DavidZambrano28/Electrical-Systems-Phoenix-Autonomy/PCB-MainBoard/PDB.kicad_pcb

## KiCad design PCB-MainBoard/PDB.kicad_pcb (2026-11-06)

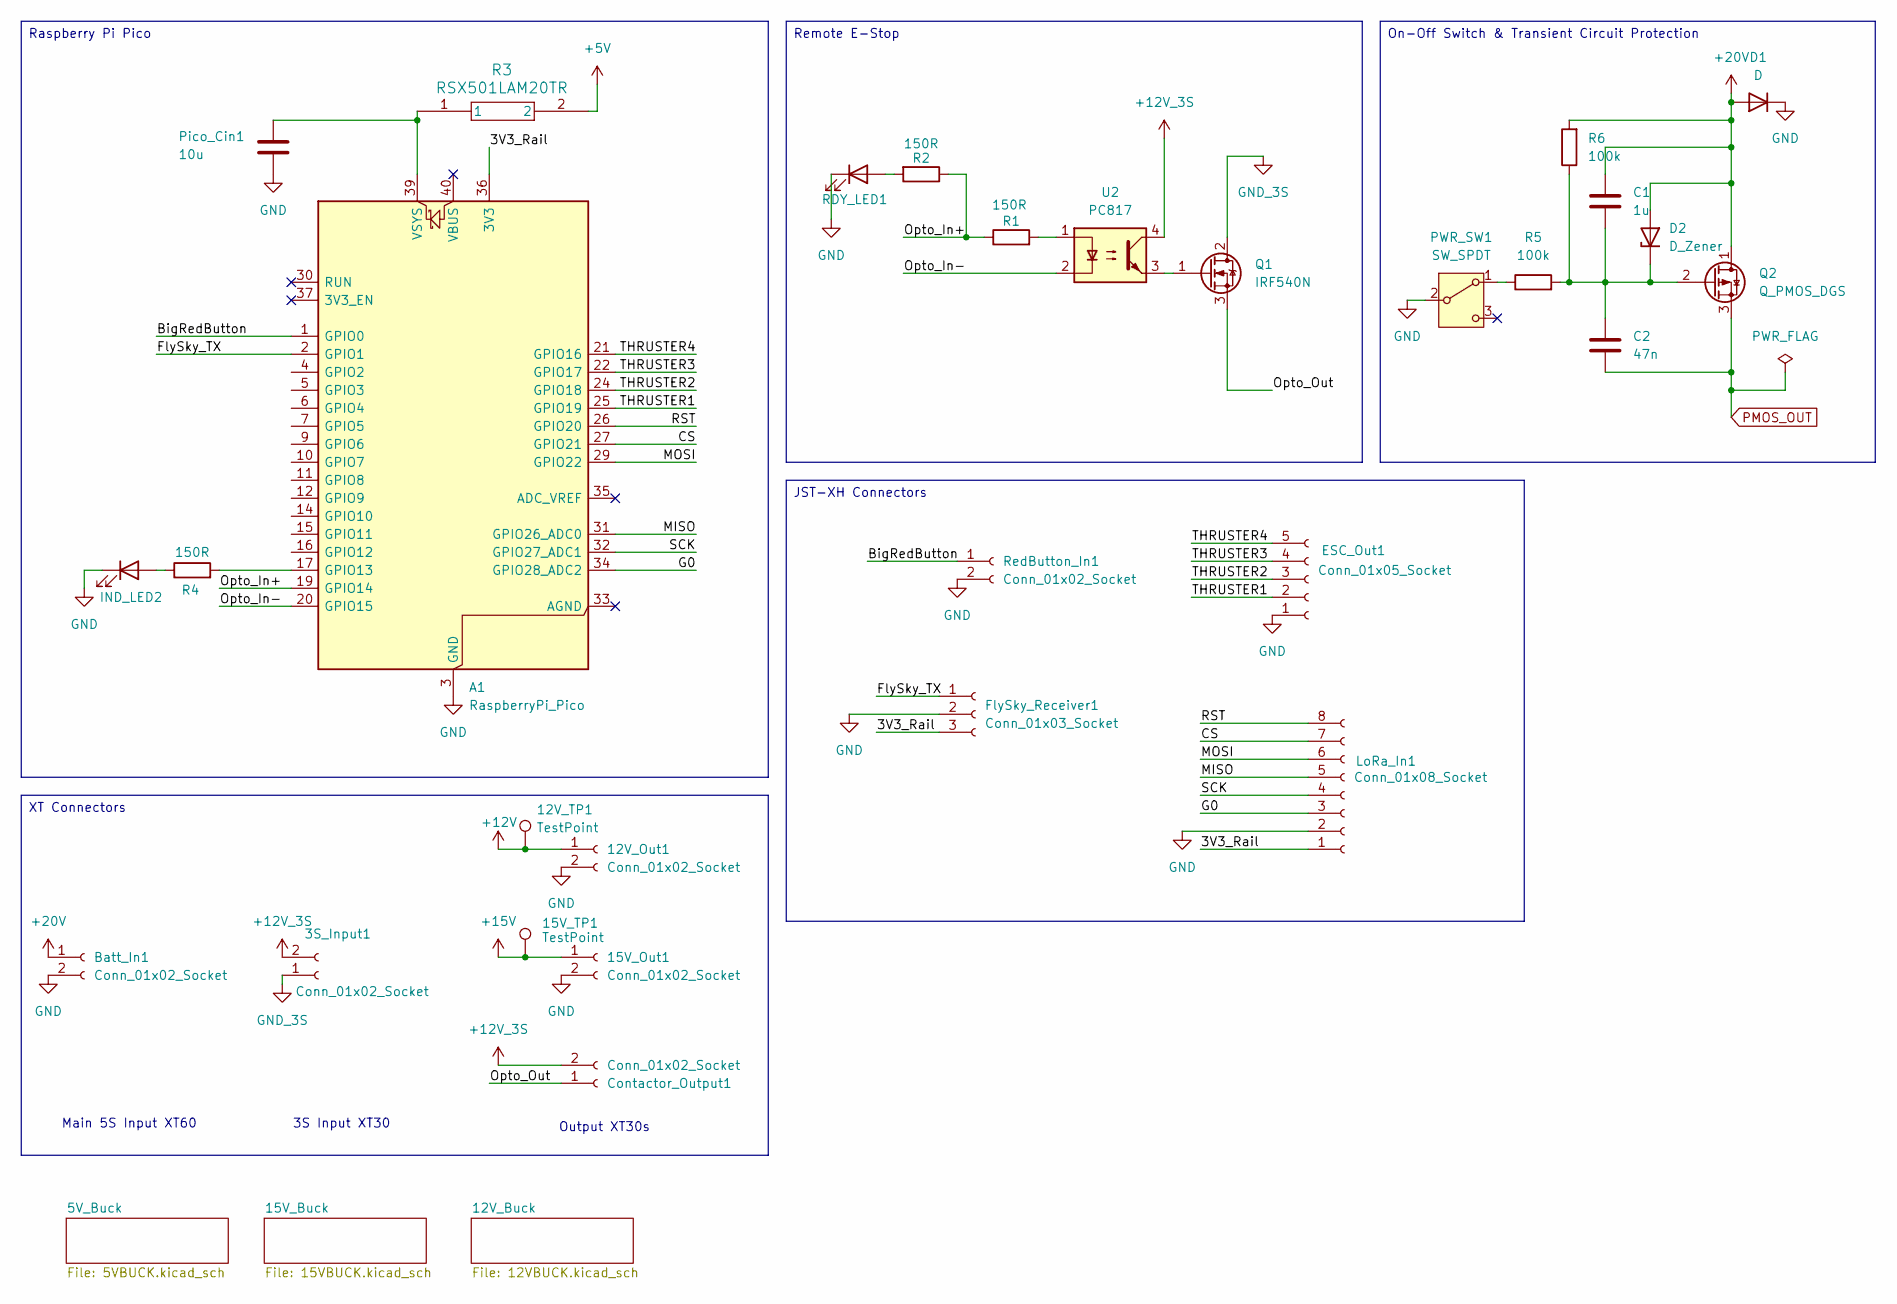
[picture p1: schematic PDB.kicad_sch]

Parts:
3S_Input1: Conn_01x02_Socket; AMASS_XT30U-M_1x02_P5.0mm_Vertical
12V_Out1, 15V_Out1: Conn_01x02_Socket; AMASS_XT30U-F_1x02_P5.0mm_Vertical
12V_TP1, 15V_TP1: TestPoint; TestPoint_Pad_D2.0mm
A1: RaspberryPi_Pico; RaspberryPi_Pico_Common_THT
Batt_In1: Conn_01x02_Socket; AMASS_XT60-M_1x02_P7.20mm_Vertical
C1: 1u; C_0603_1608Metric
C2: 47n; C_0603_1608Metric
Contactor_Output1: Conn_01x02_Socket; AMASS_XT30U-F_1x02_P5.0mm_Vertical
D1: D; D_SMC
D2: D_Zener; D_SMB
ESC_Out1: Conn_01x05_Socket; JST_XH_B5B-XH-A_1x05_P2.50mm_Vertical
FlySky_Receiver1: Conn_01x03_Socket; JST_XH_B3B-XH-A_1x03_P2.50mm_Vertical
IND_LED2: LED; LED_D5.0mm
LoRa_In1: Conn_01x08_Socket; JST_XH_B8B-XH-A_1x08_P2.50mm_Vertical
PWR_SW1: SW_SPDT; SW_Slide_SPDT_Straight_CK_OS102011MS2Q
Pico_Cin1: 10u; C_0805_2012Metric
Q1: IRF540N; TO-220-3_Vertical
Q2: Q_PMOS_DGS; TO-252-3_TabPin2
R1, R2, R4: 150R; R_0805_2012Metric
R3: RSX501LAM20TR; DIO_RB050LAM_ROM
R5, R6: 100k; R_0603_1608Metric
RDY_LED1: LED; LED_D5.0mm
RedButton_In1: Conn_01x02_Socket; JST_XH_B2B-XH-A_1x02_P2.50mm_Vertical
U2: PC817; DIP-4_W7.62mm

Connections:
+5V: R3.2; also elsewhere on the board
+12V: 12V_Out1.1, 12V_TP1.1 (1_1); also elsewhere on the board
+12V_3S: 3S_Input1.2, Contactor_Output1.2, U2.4
+15V: 15V_Out1.1, 15V_TP1.1 (1_1); also elsewhere on the board
+20V: Batt_In1.1, C1.1, D1.2 (A), D2.2 (A), Q2.1 (D), R6.2
/3V3_Rail: A1.36 (3V3), FlySky_Receiver1.3, LoRa_In1.1
/BigRedButton: A1.1 (GPIO0), RedButton_In1.1
/CS: A1.27 (GPIO21), LoRa_In1.7
/FlySky_TX: A1.2 (GPIO1), FlySky_Receiver1.1
/G0: A1.34 (GPIO28_ADC2), LoRa_In1.3
/MISO: A1.31 (GPIO26_ADC0), LoRa_In1.5
/MOSI: A1.29 (GPIO22), LoRa_In1.6
/Opto_In+: A1.19 (GPIO14), R1.1, R2.1
/Opto_In-: A1.20 (GPIO15), U2.2
/Opto_Out: Contactor_Output1.1, Q1.3 (S)
/RST: A1.26 (GPIO20), LoRa_In1.8
/SCK: A1.32 (GPIO27_ADC1), LoRa_In1.4
/THRUSTER1: A1.25 (GPIO19), ESC_Out1.2
/THRUSTER2: A1.24 (GPIO18), ESC_Out1.3
/THRUSTER3: A1.22 (GPIO17), ESC_Out1.4
/THRUSTER4: A1.21 (GPIO16), ESC_Out1.5
GND: 12V_Out1.2, 15V_Out1.2, A1.3 (GND), A1.8 (GND), A1.13 (GND), A1.18 (GND), A1.23 (GND), A1.28 (GND), A1.38 (GND), Batt_In1.2, D1.1 (K), ESC_Out1.1, FlySky_Receiver1.2, IND_LED2.1 (K), LoRa_In1.2, PWR_SW1.2 (B), Pico_Cin1.2, RDY_LED1.1 (K), RedButton_In1.2; also elsewhere on the board
GND_3S: 3S_Input1.1, Q1.2 (D)
unnamed: A1.17 (GPIO13), R4.2
unnamed: A1.39 (VSYS), Pico_Cin1.1, R3.1
unnamed: C1.2, C2.1, D2.1 (K), Q2.2 (G), R5.2, R6.1
unnamed: IND_LED2.2 (A), R4.1
unnamed: PWR_SW1.1 (A), R5.1
unnamed: Q1.1 (G), U2.3
unnamed: R1.2, U2.1
unnamed: R2.2, RDY_LED1.2 (A)
PMOS_OUT: C2.2, Q2.3 (S); also elsewhere on the board

Notes on the sheet:
Main 5S Input XT60
Output XT30s
3S Input XT30
On-Off Switch & Transient Circuit Protection
Raspberry Pi Pico
XT Connectors
Remote E-Stop
JST-XH Connectors

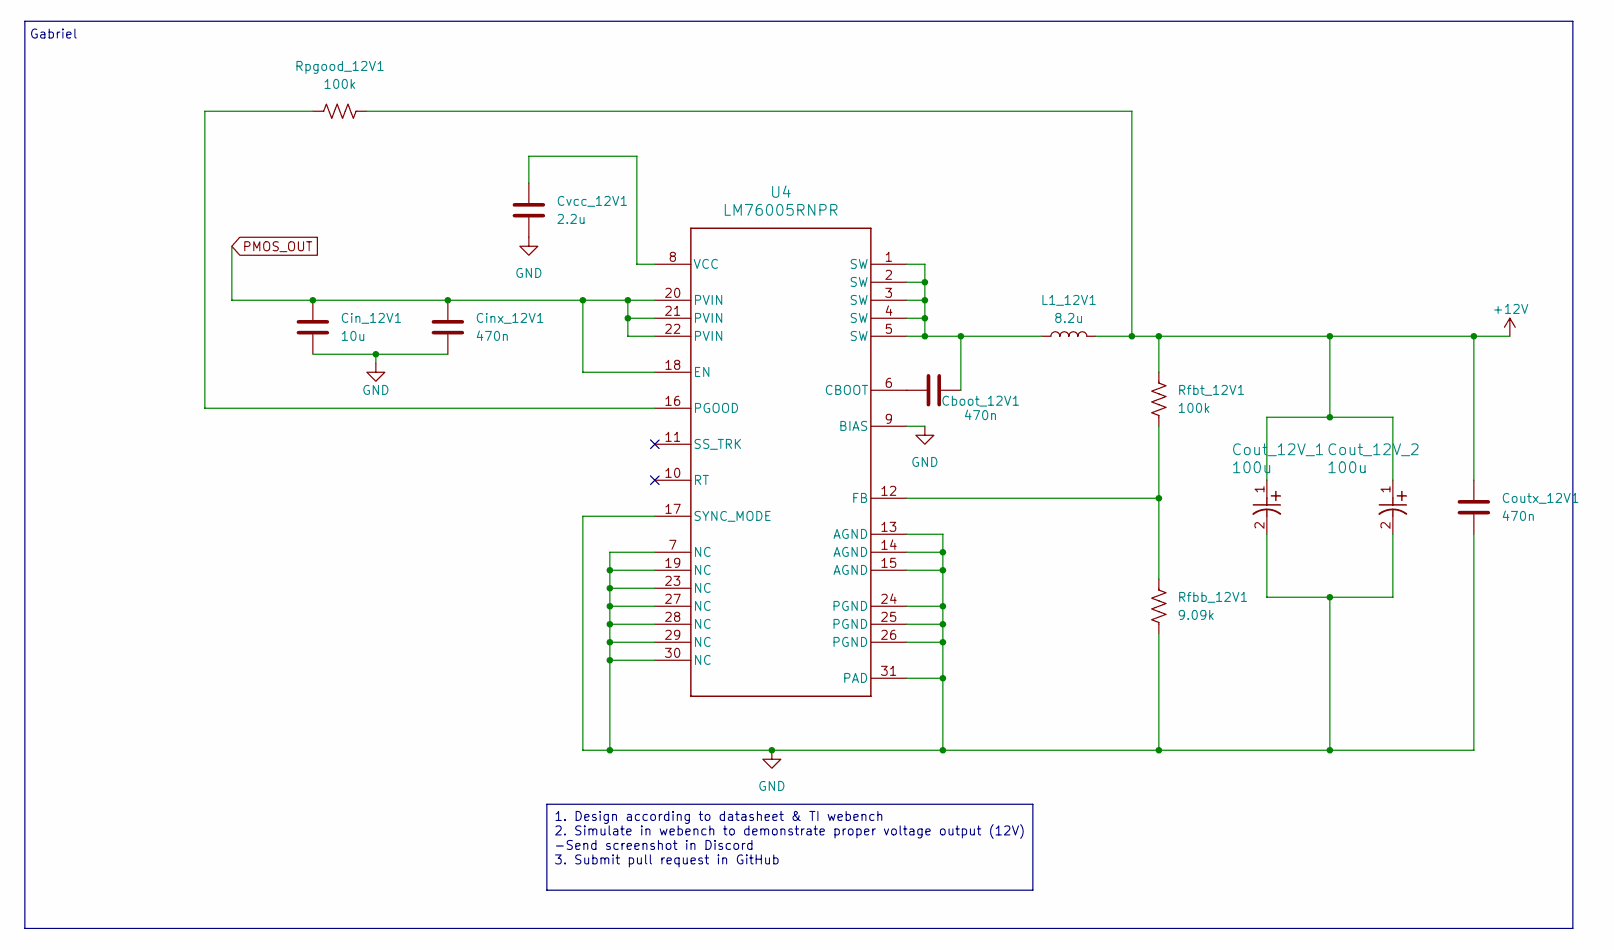
[picture p2: schematic 12VBUCK.kicad_sch, 12V Buck Converter]

Parts:
Cboot_12V1: 470n; C_0805_2012Metric
Cin_12V1: 10u; C_0805_2012Metric
Cinx_12V1: 470n; C_0805_2012Metric
Cout_12V_1, Cout_12V_2: 100u; CAP_EEFK_F_PAN
Coutx_12V1: 470n; C_0805_2012Metric
Cvcc_12V1: 2.2u; C_0603_1608Metric
L1_12V1: 8.2u; L_Bourns_SRP7028A_7.3x6.6mm
Rfbb_12V1: 9.09k; R_0603_1608Metric
Rfbt_12V1: 100k; R_0603_1608Metric
Rpgood_12V1: 100k; R_0603_1608Metric
U4: LM76005RNPR; RNP0030A

Connections:
+12V: Cout_12V_1.1, Cout_12V_2.1, Coutx_12V1.1, L1_12V1.2, Rfbt_12V1.2, Rpgood_12V1.2; also elsewhere on the board
GND: Cin_12V1.2, Cinx_12V1.2, Cout_12V_1.2, Cout_12V_2.2, Coutx_12V1.2, Cvcc_12V1.2, Rfbb_12V1.1, U4.7 (NC), U4.9 (BIAS), U4.13 (AGND), U4.14 (AGND), U4.15 (AGND), U4.17 (SYNC_MODE), U4.19 (NC), U4.23 (NC), U4.24 (PGND), U4.25 (PGND), U4.26 (PGND), U4.27 (NC), U4.28 (NC), U4.29 (NC), U4.30 (NC), U4.31 (PAD); also elsewhere on the board
unnamed: Cboot_12V1.1, L1_12V1.1, U4.1 (SW), U4.2 (SW), U4.3 (SW), U4.4 (SW), U4.5 (SW)
unnamed: Cboot_12V1.2, U4.6 (CBOOT)
unnamed: Rfbb_12V1.2, Rfbt_12V1.1, U4.12 (FB)
unnamed: Rpgood_12V1.1, U4.16 (PGOOD)
unnamed: Cvcc_12V1.1, U4.8 (VCC)
PMOS_OUT: Cin_12V1.1, Cinx_12V1.1, U4.18 (EN), U4.20 (PVIN), U4.21 (PVIN), U4.22 (PVIN); also elsewhere on the board

Notes on the sheet:
Gabriel
1. Design according to datasheet & TI webench 2. Simulate in webench to demonstrate proper voltage output (12V) -Send screenshot in Discord 3. Submit pull request in GitHub

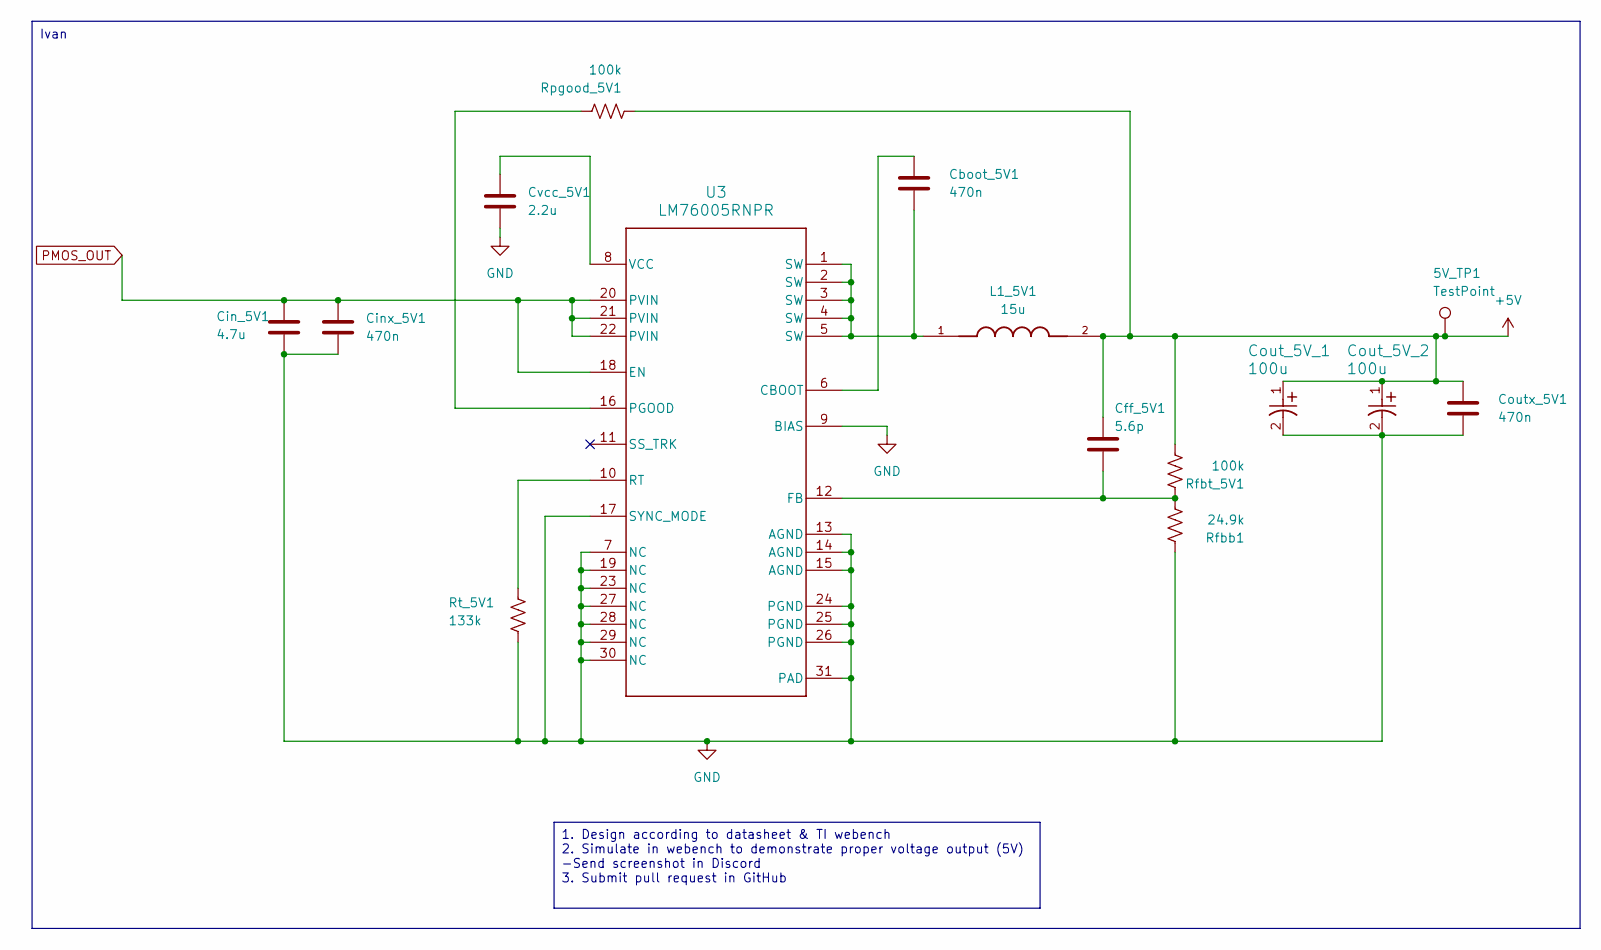
[picture p3: schematic 5VBUCK.kicad_sch, 5V Buck Converter]

Parts:
5V_TP1: TestPoint; TestPoint_Pad_D2.0mm
Cboot_5V1: 470n; C_0805_2012Metric
Cff_5V1: 5.6p; C_0603_1608Metric
Cin_5V1: 4.7u; C_0805_2012Metric
Cinx_5V1: 470n; C_0805_2012Metric
Cout_5V_1, Cout_5V_2: 100u; CAP_EEFK_F_PAN
Coutx_5V1: 470n; C_0805_2012Metric
Cvcc_5V1: 2.2u; C_0603_1608Metric
L1_5V1: 15u; IND_1217AS-H-150M=P3; PARTREV N/A
Rfbb1: 24.9k; R_0603_1608Metric
Rfbt_5V1: 100k; R_0603_1608Metric
Rpgood_5V1: 100k; R_0603_1608Metric
Rt_5V1: 133k; R_0603_1608Metric
U3: LM76005RNPR; RNP0030A

Connections:
+5V: 5V_TP1.1 (1_1), Cff_5V1.1, Cout_5V_1.1, Cout_5V_2.1, Coutx_5V1.1, L1_5V1.2, Rfbt_5V1.2, Rpgood_5V1.2; also elsewhere on the board
GND: Cin_5V1.2, Cinx_5V1.2, Cout_5V_1.2, Cout_5V_2.2, Coutx_5V1.2, Cvcc_5V1.2, Rfbb1.1, Rt_5V1.2, U3.7 (NC), U3.9 (BIAS), U3.13 (AGND), U3.14 (AGND), U3.15 (AGND), U3.17 (SYNC_MODE), U3.19 (NC), U3.23 (NC), U3.24 (PGND), U3.25 (PGND), U3.26 (PGND), U3.27 (NC), U3.28 (NC), U3.29 (NC), U3.30 (NC), U3.31 (PAD); also elsewhere on the board
unnamed: Cboot_5V1.2, L1_5V1.1, U3.1 (SW), U3.2 (SW), U3.3 (SW), U3.4 (SW), U3.5 (SW)
unnamed: Cboot_5V1.1, U3.6 (CBOOT)
unnamed: Cff_5V1.2, Rfbb1.2, Rfbt_5V1.1, U3.12 (FB)
unnamed: Rpgood_5V1.1, U3.16 (PGOOD)
unnamed: Rt_5V1.1, U3.10 (RT)
unnamed: Cvcc_5V1.1, U3.8 (VCC)
PMOS_OUT: Cin_5V1.1, Cinx_5V1.1, U3.18 (EN), U3.20 (PVIN), U3.21 (PVIN), U3.22 (PVIN); also elsewhere on the board

Notes on the sheet:
Ivan
1. Design according to datasheet & TI webench 2. Simulate in webench to demonstrate proper voltage output (5V) -Send screenshot in Discord 3. Submit pull request in GitHub

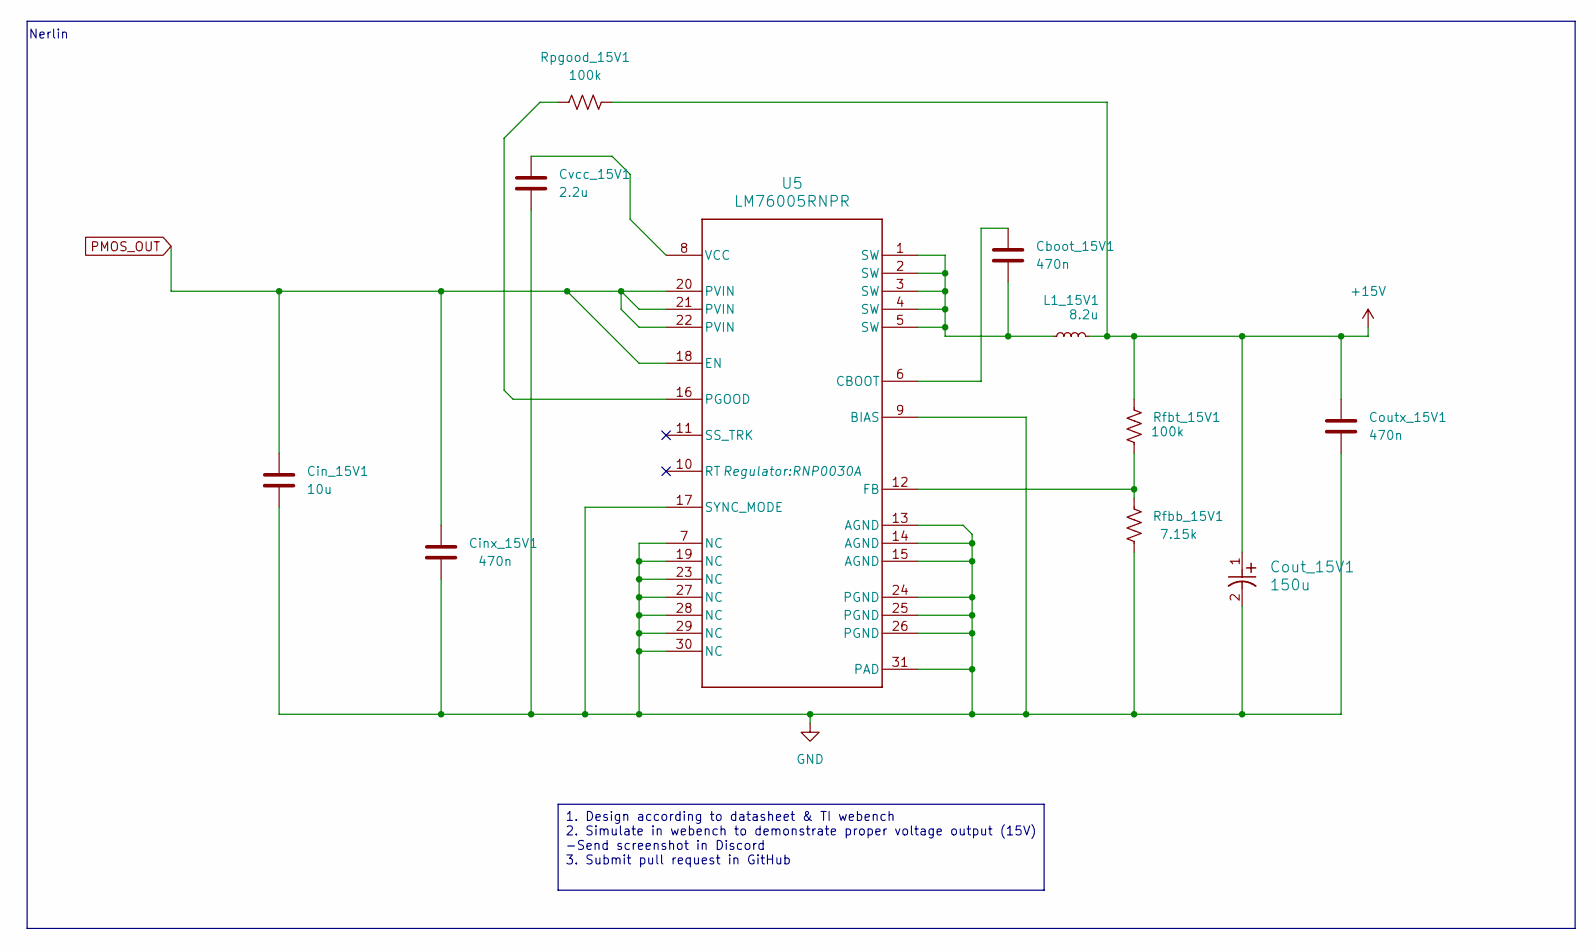
[picture p4: schematic 15VBUCK.kicad_sch, 15V Buck Converter]

Parts:
Cboot_15V1: 470n; C_0805_2012Metric
Cin_15V1: 10u; C_0805_2012Metric
Cinx_15V1: 470n; C_0805_2012Metric
Cout_15V1: 150u; CAP_EEFK_F_PAN
Coutx_15V1: 470n; C_0805_2012Metric
Cvcc_15V1: 2.2u; C_0603_1608Metric
L1_15V1: 8.2u; L_Bourns_SRP7028A_7.3x6.6mm
Rfbb_15V1: 7.15k; R_0603_1608Metric
Rfbt_15V1: 100k; R_0603_1608Metric
Rpgood_15V1: 100k; R_0603_1608Metric
U5: LM76005RNPR; RNP0030A

Connections:
+15V: Cout_15V1.1, Coutx_15V1.1, L1_15V1.2, Rfbt_15V1.2, Rpgood_15V1.2; also elsewhere on the board
GND: Cin_15V1.2, Cinx_15V1.2, Cout_15V1.2, Coutx_15V1.2, Cvcc_15V1.2, Rfbb_15V1.1, U5.7 (NC), U5.9 (BIAS), U5.13 (AGND), U5.14 (AGND), U5.15 (AGND), U5.17 (SYNC_MODE), U5.19 (NC), U5.23 (NC), U5.24 (PGND), U5.25 (PGND), U5.26 (PGND), U5.27 (NC), U5.28 (NC), U5.29 (NC), U5.30 (NC), U5.31 (PAD); also elsewhere on the board
unnamed: Cboot_15V1.2, L1_15V1.1, U5.1 (SW), U5.2 (SW), U5.3 (SW), U5.4 (SW), U5.5 (SW)
unnamed: Cboot_15V1.1, U5.6 (CBOOT)
unnamed: Rfbb_15V1.2, Rfbt_15V1.1, U5.12 (FB)
unnamed: Rpgood_15V1.1, U5.16 (PGOOD)
unnamed: Cvcc_15V1.1, U5.8 (VCC)
PMOS_OUT: Cin_15V1.1, Cinx_15V1.1, U5.18 (EN), U5.20 (PVIN), U5.21 (PVIN), U5.22 (PVIN); also elsewhere on the board

Notes on the sheet:
Nerlin
1. Design according to datasheet & TI webench 2. Simulate in webench to demonstrate proper voltage output (15V) -Send screenshot in Discord 3. Submit pull request in GitHub

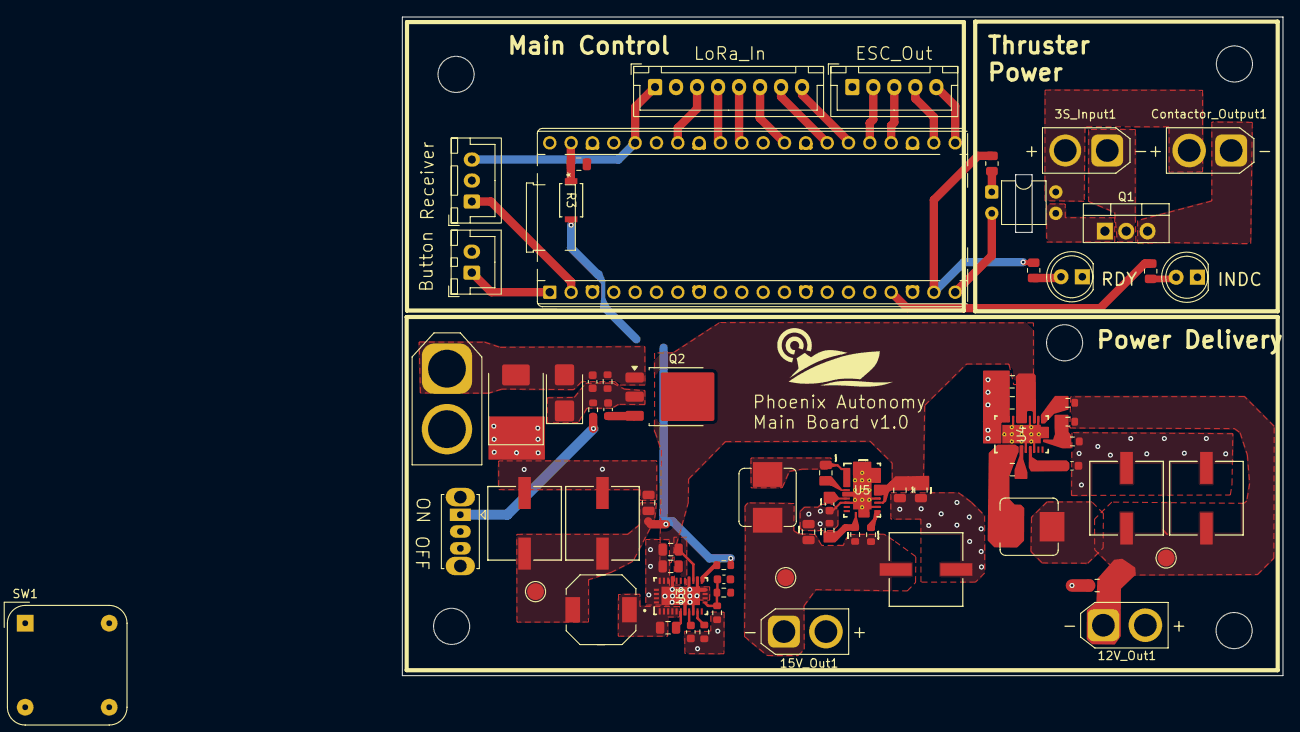
[picture p5: board PDB.kicad_pcb from above]

Board: 4 copper layers, 104.8 x 78.4 mm, 68 parts (0 on the bottom side), 48 nets.

Other parts of the board:
SW1: SW_SPST; Choke_Schaffner_RN102-04-14.0x14.0mm

Their connections:
GND: SW1.1 (A); also elsewhere on the board
