DavidZambrano28/Electrical-Systems-Phoenix-Autonomy/(commit log)

2026-10-28 updated the pcd layout
    [PDB.kicad_pcb]
2026-10-31 updated pcb layout
    [12VBUCK.kicad_sch, 15VBUCK.kicad_sch, 5VBUCK.kicad_sch, PDB.kicad_pcb, PDB.kicad_sch]
2026-10-31 Updated only the kicad_pcb
    [PDB.kicad_pcb]
2026-10-31 Updated PDB Schematic for 12V Buck
    [PDB.kicad_pcb]
2026-10-31 Layout for 5V buck converter
    [PDB.kicad_pcb]
2026-11-01 Upload buck converter merged layout
    Uploaded kicad_pcb file that contains all three layouts for the 5V, 12V, and 15V buck converter circuits.
    [PDB.kicad_pcb]
2026-11-03 Upload merged layout w/ Pico & Emergency Stop Additions
    Upload first complete draft of the PCB, with the raspberry pi pico, JST-XH connectors for interfacing with ESC & LoRa modules, big red button, and FlySky receiver, and remote emergency stop circuit (optocoupler, NMOS) along with all corresponding XT connectors.
    [12VBUCK.kicad_sch, 15VBUCK.kicad_sch, 5VBUCK.kicad_sch, PDB.kicad_pcb, PDB.kicad_sch]
2026-11-03 Upload Schottky Diode
    This Schottky Diode will protect the 5V buck converter powering the Pico. With this we will be able to power the pico with the 5V buck converter as well as plug in the USB to upload code and debug.
2026-11-06 Added circuit protection rough draft
    Added generic components and loose traces for circuit protection including a TVS diode and soft start circuit. Said circuit includes a PMOS whose output is now the net for the Vcc input of the buck regulators.
    [12VBUCK.kicad_sch, 15VBUCK.kicad_sch, 5VBUCK.kicad_sch, PDB.kicad_pcb, PDB.kicad_sch]
2026-11-06 Upload remaining files for circuit protection rough draft
    Gotta include all files for any major changes.
2026-11-06 Beginning merge of repos for thruster control & board
    This repository will become the main repository for all electrical items for the RoboBoat team, beginning by merging the thruster code.
2026-11-06 Moving everything to this folder.
    [12VBUCK.kicad_sch, 15VBUCK.kicad_sch, 5VBUCK.kicad_sch, PDB.kicad_pcb, PDB.kicad_sch]
